harokr/341AP2020/(commit log)

2020-11-20 Create AudioFrequencyDetectorV1-0.ino
    FFT Sampler
2020-11-26 Circuit assembly
    Got the amplifying circuit to pick up frequencies
    [PowerVsFrequency.xlsx]
2021-02-05 Feb commit
    Updated the repo for a final presentable look.
    [PowerVsFrequency.xlsx]
